huytrinh0911/Wall-following-robot/README.md

# Wall-following Robot

**Technologies:** STM32F103, Ultrasonic HC-SR04  
**Tools:** CubeMX, Keil C (C language)  

Designed and built a wall-following robot using a PID controller to maintain a fixed distance from the wall.  

▶️ [Watch demo video](https://drive.google.com/drive/folders/1D8NbhbKwnxwDvEDlrJQ0wRU1cvop0SBq?usp=sharing)
