huytrinh0911/Wall-following-robot/Core/Src/main.c

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
/* Includes ------------------------------------------------------------------*/
#include "main.h"

/* USER CODE BEGIN Includes */
#include "encoder.h"
#include "takesample.h"
#include "exfunction.h"
#include "ultrasonic.h"
#include "pid.h"
#include "pwm.h"
#include "controlmotor.h"
#include "testprogram00.h"

#include <math.h>
#include <stdint.h>
#include <string.h>
/* USER CODE END Includes */

ADC_HandleTypeDef hadc1;

IWDG_HandleTypeDef hiwdg;

TIM_HandleTypeDef htim1;
TIM_HandleTypeDef htim2;
TIM_HandleTypeDef htim3;
TIM_HandleTypeDef htim4;

UART_HandleTypeDef huart2;
DMA_HandleTypeDef hdma_usart2_tx;

DMA_HandleTypeDef hdma_memtomem_dma1_channel1;
/* USER CODE BEGIN PV */

// General Flag/Variable
volatile uint8_t Sample_flag = 0;
volatile uint8_t Sample_enc_flag = 0;

volatile const float Sample_time_ms = 20;
float const PI = 3.14159265359;
uint16_t test = 0;
// ---------------------------------------------------------------------------------


// Ultrasonic Variable
uint32_t InCapFR_01 = 0;
uint32_t InCapFR_02 = 0;
uint32_t InCapRFR_01 = 0;
uint32_t InCapRFR_02 = 0;
uint32_t InCapRBR_01 = 0;
uint32_t InCapRBR_02 = 0;

uint32_t diff_f = 0;
uint32_t diff_rf = 0;
uint32_t diff_rb = 0;
uint8_t IsFirstCap = 0;

float Front_dis = 0;
float RightFront_dis = 0;
float RightBack_dis = 0;

volatile uint8_t F_done = 0;
volatile uint8_t RF_done = 0;
volatile uint8_t RB_done = 0;

float theta = 0;
float dis = 0;
float omega = 0;

volatile uint8_t Front_close = 0;
volatile uint8_t Front_distant = 0;
volatile uint8_t Turn_Left = 0;

volatile uint8_t Turn_Right_RF = 0;
volatile uint8_t Turn_Right_RB = 0;
volatile uint8_t Turn_Right = 0;



// ---------------------------------------------------------------------------------


// Encoder Variable
volatile uint8_t isChange_R = 0;
volatile uint8_t isChange_L = 0;

volatile uint16_t pre_encR_cnt = 0;
volatile float preR = 0;
volatile uint16_t encR_cnt_PA0_PA1 = 0;
volatile uint16_t encR_cnt = 0;
volatile int16_t encR_cnt_0 = 0;
volatile int16_t encR_cnt_1 = 0;


volatile uint16_t pre_encL_cnt = 0;
volatile uint16_t encL_cnt_PA6_PA7 = 0;
volatile uint16_t encL_cnt = 0;
volatile int16_t encL_cnt_0 = 0;
volatile int16_t encL_cnt_1 = 0;


volatile float omegaR = 0;
volatile float omegaL = 0;
float rpmR = 0;
float rpmL = 0;
float rpsR = 0;
float rpsL = 0;

volatile float omegaR_SP = 0;
volatile float omegaL_SP = 0;
// ---------------------------------------------------------------------------------


// Right Motor PID Variable
float Kp_R = 40;
float Ki_R = 80;
float Kd_R = 0.3;
/* 
Ngon:	50	40	0
							
*/
float uk_R = 0;
float uk_1_R = 0;
float ek_R = 0;
float ek_1_R = 0;
float ek_2_R = 0;

float const umax_R = 399;
float const umin_R = -399;
float PID_R = 0;
// ---------------------------------------------------------------------------------


// Left Motor PID Variable
float Kp_L = 40;
float Ki_L = 80;
float Kd_L = 0.3;

float uk_L = 0;
float uk_1_L = 0;
float ek_L = 0;
float ek_1_L = 0;
float ek_2_L = 0;

float const umax_L = 399;
float const umin_L = -399;
float PID_L = 0;
// ---------------------------------------------------------------------------------


// Distance PID Variable
float distance_setpoint = 30;
float v_setpoint = 25;
	
float Kp_dis = 100;	// 100 25 0.75
float Ki_dis = 25;
float Kd_dis = 0.75;

float uk_dis = 0;
float uk_1_dis = 0;
float ek_dis = 0;
float ek_1_dis = 0;
float ek_2_dis = 0;

float const umax_dis = 400;
float const umin_dis = -400;
float PID_dis = 0;
// ---------------------------------------------------------------------------------

// Extern Variable
uint8_t omegaR_buff[sizeof(float)] = {0};
uint8_t omegaL_buff[sizeof(float)] = {0};

uint16_t pwm_setup01 = 0;
uint16_t pwm_setup02 = 0;

// ---------------------------------------------------------------------------------


/* USER CODE END PV */

void SystemClock_Config(void);
static void MX_GPIO_Init(void);
static void MX_DMA_Init(void);
static void MX_TIM1_Init(void);
static void MX_TIM2_Init(void);
static void MX_TIM3_Init(void);
static void MX_TIM4_Init(void);
static void MX_USART2_UART_Init(void);
static void MX_ADC1_Init(void);
static void MX_IWDG_Init(void);
/* USER CODE BEGIN 0 */

	void HAL_TIM_IC_CaptureCallback(TIM_HandleTypeDef *htim)
	{ 
		// Ultrasonic
		if(htim->Instance == TIM1)
		{
//			test0 = 2603;
			// TIMER 1, CHANNEL 1 - Ultrasonic RigtBack
			if(htim->Channel == HAL_TIM_ACTIVE_CHANNEL_1)
			{
				if(IsFirstCap == 0)
				{
					InCapRBR_01 = HAL_TIM_ReadCapturedValue(htim, TIM_CHANNEL_1); // read the first value
					IsFirstCap = 1; // set the first captured as true
					// Now change the plarity to falling edge
					__HAL_TIM_SET_CAPTUREPOLARITY(htim, TIM_CHANNEL_1, TIM_INPUTCHANNELPOLARITY_FALLING);
				}
				else if (IsFirstCap == 1) // if the first is already captured
				{
					InCapRBR_02 = HAL_TIM_ReadCapturedValue(htim, TIM_CHANNEL_1); // read second value
//					__HAL_TIM_SET_COUNTER(htim,0); // reset the counter
					
					if(InCapRBR_02 > InCapRBR_01)
					{
						diff_rb = InCapRBR_02 - InCapRBR_01;
					}
					else if (InCapRBR_01 > InCapRBR_02)
					{
						diff_rb = (19999 - InCapRBR_01) + InCapRBR_02;
					}
					RightBack_dis = roundf((diff_rb * 0.017)*10)/10 + 0.25;
					IsFirstCap = 0; // set it back to false
					
					// set polarity to rising edge
					__HAL_TIM_SET_CAPTUREPOLARITY(htim, TIM_CHANNEL_1, TIM_INPUTCHANNELPOLARITY_RISING);
					__HAL_TIM_DISABLE_IT(&htim1, TIM_IT_CC1);
					RB_done = 1;
				}
			}
			// TIMER 1, CHANNEL 2 - Ultrasonic RightFront
			else if(htim->Channel == HAL_TIM_ACTIVE_CHANNEL_2)
			{
				if(IsFirstCap == 0)
				{
					InCapRFR_01 = HAL_TIM_ReadCapturedValue(htim, TIM_CHANNEL_2); // read the first value
					IsFirstCap = 1; // set the first captured as true
					// Now change the plarity to falling edge
					__HAL_TIM_SET_CAPTUREPOLARITY(htim, TIM_CHANNEL_2, TIM_INPUTCHANNELPOLARITY_FALLING);
				}
				else if (IsFirstCap == 1) // if the first is already captured
				{
					InCapRFR_02 = HAL_TIM_ReadCapturedValue(htim, TIM_CHANNEL_2); // read second value
//					__HAL_TIM_SET_COUNTER(htim,0); // reset the counter
					
					if(InCapRFR_02 > InCapRFR_01)
					{
						diff_rf = InCapRFR_02 - InCapRFR_01;
					}
					else if (InCapRFR_01 > InCapRFR_02)
					{
						diff_rf = (19999 - InCapRFR_01) + InCapRFR_02;
					}
					RightFront_dis = roundf((diff_rf * 0.017)*10)/10 - 0.25;
					IsFirstCap = 0; // set it back to false
					
					// set polarity to rising edge
					__HAL_TIM_SET_CAPTUREPOLARITY(htim, TIM_CHANNEL_2, TIM_INPUTCHANNELPOLARITY_RISING);
					__HAL_TIM_DISABLE_IT(&htim1, TIM_IT_CC2);
					RF_done = 1;
				}
			}
			// TIMER 1, CHANNEL 3 - Ultrasonic Front
			else if(htim->Channel == HAL_TIM_ACTIVE_CHANNEL_3)
			{
				if(IsFirstCap == 0)
				{
					InCapFR_01 = HAL_TIM_ReadCapturedValue(htim, TIM_CHANNEL_3); // read the first value
					IsFirstCap = 1; // set the first captured as true
					// Now change the plarity to falling edge
					__HAL_TIM_SET_CAPTUREPOLARITY(htim, TIM_CHANNEL_3, TIM_INPUTCHANNELPOLARITY_FALLING);
				}
				else if (IsFirstCap == 1) // if the first is already captured
				{
					InCapFR_02 = HAL_TIM_ReadCapturedValue(htim, TIM_CHANNEL_3); // read second value
//					__HAL_TIM_SET_COUNTER(htim,0); // reset the counter
					
					if(InCapFR_02 > InCapFR_01)
					{
						diff_f = InCapFR_02 - InCapFR_01;
					}
					else if (InCapFR_01 > InCapFR_02)
					{
						diff_f = (19999 - InCapFR_01) + InCapFR_02;
					}
					Front_dis = roundf((diff_f * 0.017)*10)/10;
					IsFirstCap = 0; // set it back to false
					
					// set polarity to rising edge
					__HAL_TIM_SET_CAPTUREPOLARITY(htim, TIM_CHANNEL_3, TIM_INPUTCHANNELPOLARITY_RISING);
					__HAL_TIM_DISABLE_IT(&htim1, TIM_IT_CC3);
					F_done = 1;
				}
			}
		}
		// Encoder
		else if (htim->Instance == TIM2) 
		{
			encR_cnt = (__HAL_TIM_GET_COUNTER(htim));
//			encL_cnt = (__HAL_TIM_GET_COUNTER(&htim3));

			isChange_R = 1;
		}
		else if (htim->Instance == TIM3) 
		{
//			encL_cnt = (__HAL_TIM_GET_COUNTER(htim));
			isChange_L = 1;
		}
	}


	void HAL_TIM_PeriodElapsedCallback(TIM_HandleTypeDef *htim)
{
	if(htim->Instance == htim1.Instance)
	{
		Encoder_processing_ver1();
//		
		PID_R = PID_R_control(omegaR_SP, omegaR);
		PID_L = PID_L_control(omegaL_SP, omegaL);
////		
//		PID_R = PID_R_control(5, omegaR);
//		PID_L = PID_L_control(6, omegaL);
		
//		SendToMATLAB_omegaR();
////		
		PIDtoPWM_R_ver1(PID_R);
		PIDtoPWM_L_ver1(PID_L);
		
		//HAL_IWDG_Refresh(&hiwdg);

	}
}
/* USER CODE END 0 */

/**
  * @brief  The application entry point.
  * @retval int
  */
int main(void)
{
  /* MCU Configuration--------------------------------------------------------*/

  /* Reset of all peripherals, Initializes the Flash interface and the Systick. */
  HAL_Init();

  /* Configure the system clock */
  SystemClock_Config();

  /* Initialize all configured peripherals */
  MX_GPIO_Init();
  MX_DMA_Init();
  MX_TIM1_Init();
  MX_TIM2_Init();
  MX_TIM3_Init();
  MX_TIM4_Init();
  MX_USART2_UART_Init();
  MX_ADC1_Init();
  MX_IWDG_Init();
  /* USER CODE BEGIN 2 */
	
	__HAL_TIM_SET_COUNTER(&htim2, 0x8000);
	__HAL_TIM_SET_COUNTER(&htim3, 0x8000);

	
	HAL_TIM_Base_Start_IT(&htim1);
	__HAL_TIM_ENABLE_IT(&htim1, TIM_IT_UPDATE);
	
	HAL_TIM_IC_Start_IT(&htim1, TIM_CHANNEL_1);
	HAL_TIM_IC_Start_IT(&htim1, TIM_CHANNEL_2);
	HAL_TIM_IC_Start_IT(&htim1, TIM_CHANNEL_3);
	
	HAL_TIM_Encoder_Start_IT(&htim2, TIM_CHANNEL_ALL);
	HAL_TIM_Encoder_Start_IT(&htim3, TIM_CHANNEL_ALL);
	
	HAL_TIM_PWM_Start(&htim4, TIM_CHANNEL_1);
	HAL_TIM_PWM_Start(&htim4, TIM_CHANNEL_2);
	
	HAL_GPIO_WritePin(GPIOC, GPIO_PIN_13, GPIO_PIN_RESET);
	
//	pwm_setup01 = 325;
//	setup01();
	
//	pwm_setup02 = 0;
//	setup02();

//	setup00();
//	HAL_Delay(500);


  /* USER CODE END 2 */

  /* Infinite loop */
  /* USER CODE BEGIN WHILE */
  while (1)
  {
//		setup01();
//		setup02();

//		test_enc_R(); //dem counter
//		test_enc_L();

//		sample_enc_ver0();
//		sample_enc_ver1();
//		sample_enc_ver2();
//		sample_enc_ver3();


//		sample_speedctrl_ver2();

//		sample_all_ver0();		
//		sample_all_ver1();
//		sample_all_ver2();
//		sample_all_ver3();
		sample_all_ver4();
		


    /* USER CODE END WHILE */

    /* USER CODE BEGIN 3 */
  }
  /* USER CODE END 3 */
}

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
