huytrinh0911/Wall-following-robot/Core/Inc/main.h

#define Encoder_Channel_A_Right_Pin GPIO_PIN_0
#define Encoder_Channel_A_Right_GPIO_Port GPIOA
#define Encoder_Channel_B_Right_Pin GPIO_PIN_1
#define Encoder_Channel_B_Right_GPIO_Port GPIOA
#define Encoder_Channel_A_Left_Pin GPIO_PIN_6
#define Encoder_Channel_A_Left_GPIO_Port GPIOA
#define Encoder_Channel_B_Left_Pin GPIO_PIN_7
#define Encoder_Channel_B_Left_GPIO_Port GPIOA
#define Right_control_1_Pin GPIO_PIN_10
#define Right_control_1_GPIO_Port GPIOB
#define Right_control_2_Pin GPIO_PIN_11
#define Right_control_2_GPIO_Port GPIOB
#define Ultrasonic_Trigger_RightBack_Pin GPIO_PIN_13
#define Ultrasonic_Trigger_RightBack_GPIO_Port GPIOB
#define Ultrasonic_Trigger_RightFront_Pin GPIO_PIN_14
#define Ultrasonic_Trigger_RightFront_GPIO_Port GPIOB
#define Ultrasonic_Trigger_Front_Pin GPIO_PIN_15
#define Ultrasonic_Trigger_Front_GPIO_Port GPIOB
#define Ultrasonic_Echo_RightBack_Pin GPIO_PIN_8
#define Ultrasonic_Echo_RightBack_GPIO_Port GPIOA
#define Ultrasonic_Echo_RightFront_Pin GPIO_PIN_9
#define Ultrasonic_Echo_RightFront_GPIO_Port GPIOA
#define Ultrasonic_Echo_Front_Pin GPIO_PIN_10
#define Ultrasonic_Echo_Front_GPIO_Port GPIOA
#define Left_control_1_Pin GPIO_PIN_4
#define Left_control_1_GPIO_Port GPIOB
#define Left_control_2_Pin GPIO_PIN_5
#define Left_control_2_GPIO_Port GPIOB
#define PWM_Left_Pin GPIO_PIN_6
#define PWM_Left_GPIO_Port GPIOB
#define PWM_Right_Pin GPIO_PIN_7
#define PWM_Right_GPIO_Port GPIOB
